mvipin/biped-hybrid/(commit log)

2021-04-18 Initial version with kinematic chains and test movement of one leg
2021-05-01 Refactor and add support for the second leg
2021-05-02 Adjust the paramters to accomodate the torque-speed characteristics of the motors
2021-05-05 Add actuation for the foot joint
